shreyaans27/RISCV-tapeout/lef/report_final.txt

==============================================================================
LEF INSPECTION REPORT  --  original_backup/team2stdcells_final.lef
==============================================================================

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

------------------------------------------------------------------------------
DIRECTION FIELD USAGE (signal pins only)
------------------------------------------------------------------------------
  INOUT       126 pins
  (none)      2 pins

------------------------------------------------------------------------------
PER-CELL ANTENNA DATA PRESENCE
------------------------------------------------------------------------------

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

dfrtp_1        RESET    ---     INPUT_by_name           ANTENNADIFFAREAx3(0.5152@METAL1,0.5152@METAL2,0.5152@METAL3)  ANTENNAGATEAREAx3(0.2772@METAL1,0.2772@METAL2,0.5544@METAL3)  ANTENNAMAXAREACARx2(12.4163@METAL3,11.6858@METAL2)  ANTENNAMAXCUTCARx2(0.4877@VIA12,0.7316@VIA23)  ANTENNAMODELx1(OXIDE1)  ANTENNAPARTIALCUTAREAx2(0.1352@VIA12,0.0676@VIA23)  ANTENNAPARTIALMETALAREAx1(1.4424@METAL2)
dfrtp_1        NCLK     ---     INPUT_clock_by_name     ANTENNADIFFAREAx3(0.5152@METAL1,0.5152@METAL2,0.5152@METAL3)  ANTENNAGATEAREAx3(0.1980@METAL1,0.1980@METAL2,0.3960@METAL3)  ANTENNAMAXAREACARx2(3.9106@METAL3,1.8879@METAL2)  ANTENNAMAXCUTCARx2(0.6828@VIA12,1.0242@VIA23)  ANTENNAMODELx1(OXIDE1)  ANTENNAPARTIALCUTAREAx2(0.1352@VIA12,0.0676@VIA23)
dfrtp_1        D        INOUT   INPUT_by_name           ANTENNAGATEAREAx2(0.1980@METAL2,0.1980@METAL1)  ANTENNAMAXAREACARx1(1.8879@METAL2)  ANTENNAMAXCUTCARx1(0.6828@VIA12)  ANTENNAMODELx1(OXIDE1)  ANTENNAPARTIALCUTAREAx1(0.1352@VIA12)
dfrtp_1        Q        INOUT   OUTPUT_by_name          ANTENNADIFFAREAx2(0.7752@METAL2,0.2204@METAL1)  ANTENNAGATEAREAx2(0.1980@METAL2,0.1980@METAL1)  ANTENNAMAXAREACARx1(1.8879@METAL2)  ANTENNAMAXCUTCARx1(0.6828@VIA12)  ANTENNAMODELx1(OXIDE1)  ANTENNAPARTIALCUTAREAx1(0.1352@VIA12)
dfrtp_1        CLK      INOUT   INPUT_clock_by_name     ANTENNAGATEAREAx3(0.1584@METAL1,0.1584@METAL2,0.5544@METAL3)  ANTENNAMAXAREACARx2(5.5398@METAL3,2.7699@METAL2)  ANTENNAMAXCUTCARx2(0.8535@VIA12,1.2803@VIA23)  ANTENNAMODELx1(OXIDE1)  ANTENNAPARTIALCUTAREAx2(0.1352@VIA12,0.0676@VIA23)
dfrtp_1        RESET_B  INOUT   INPUT_by_name           ANTENNAGATEAREAx2(0.1584@METAL2,0.1584@METAL1)  ANTENNAMAXAREACARx1(2.7699@METAL2)  ANTENNAMAXCUTCARx1(0.8535@VIA12)  ANTENNAMODELx1(OXIDE1)  ANTENNAPARTIALCUTAREAx1(0.1352@VIA12)

dfsbp_1        CLK      INOUT   INPUT_clock_by_name     ANTENNAGATEAREAx2(0.1584@METAL2,0.1584@METAL1)  ANTENNAMAXAREACARx1(1.4205@METAL2)  ANTENNAMAXCUTCARx1(0.4268@VIA12)  ANTENNAMODELx1(OXIDE1)  ANTENNAPARTIALCUTAREAx1(0.0676@VIA12)
dfsbp_1        D        INOUT   INPUT_by_name           ANTENNAGATEAREAx2(0.1584@METAL2,0.1584@METAL1)  ANTENNAMAXAREACARx1(1.2784@METAL2)  ANTENNAMAXCUTCARx1(0.4268@VIA12)  ANTENNAMODELx1(OXIDE1)  ANTENNAPARTIALCUTAREAx1(0.0676@VIA12)
dfsbp_1        SET_B    INOUT   INPUT_by_name           ANTENNAGATEAREAx2(0.3168@METAL2,0.1584@METAL1)  ANTENNAMAXAREACARx1(1.6414@METAL2)  ANTENNAMAXCUTCARx1(0.4268@VIA12)  ANTENNAMODELx1(OXIDE1)  ANTENNAPARTIALCUTAREAx1(0.0676@VIA12)
dfsbp_1        Q_N      INOUT   OUTPUT_by_name          ANTENNADIFFAREAx2(0.5768@METAL2,0.5768@METAL1)  ANTENNAPARTIALCUTAREAx1(0.1352@VIA12)  ANTENNAPARTIALMETALAREAx1(0.2047@METAL2)
dfsbp_1        Q        INOUT   OUTPUT_by_name          ANTENNADIFFAREAx2(0.5768@METAL2,0.5768@METAL1)  ANTENNAPARTIALCUTAREAx1(0.1352@VIA12)  ANTENNAPARTIALMETALAREAx1(0.2092@METAL2)

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

dlxbp_1        Q_N      INOUT   OUTPUT_by_name          ANTENNADIFFAREAx2(0.5768@METAL2,0.5768@METAL1)  ANTENNAPARTIALCUTAREAx1(0.1352@VIA12)
dlxbp_1        D        INOUT   INPUT_by_name           ANTENNAGATEAREAx2(0.1584@METAL2,0.1584@METAL1)  ANTENNAMAXAREACARx1(1.2784@METAL2)  ANTENNAMAXCUTCARx1(0.4268@VIA12)  ANTENNAMODELx1(OXIDE1)  ANTENNAPARTIALCUTAREAx1(0.0676@VIA12)
dlxbp_1        Q        INOUT   OUTPUT_by_name          ANTENNADIFFAREAx2(0.5768@METAL2,0.5768@METAL1)  ANTENNAPARTIALCUTAREAx1(0.1352@VIA12)
dlxbp_1        GATE     INOUT   INPUT_clock_by_name     ANTENNAGATEAREAx2(0.1584@METAL2,0.1584@METAL1)  ANTENNAMAXAREACARx1(1.2784@METAL2)  ANTENNAMAXCUTCARx1(0.4268@VIA12)  ANTENNAMODELx1(OXIDE1)  ANTENNAPARTIALCUTAREAx1(0.0676@VIA12)

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

==============================================================================
SUMMARY
==============================================================================
Cells COMPLETE (38):
  a211o_2
  a21oi_1
  a21oi_2
  a21oi_4
  a21oi_8
  a22oi_1
  a22oi_2
  buf_1
  buf_16
  buf_2
  buf_4
  buf_8
  dfrtp_1
  dfsbp_1
  dfxtp_1
  dlxbp_1
  inv_1
  inv_16
  inv_2
  inv_4
  inv_8
  mux2
  mux2i
  nand2_1
  nand2_2
  nand2_4
  nand2_8
  nand2b_1
  nand4_1
  nor2_1
  nor2_4
  nor2_8
  o21ai_1
  o21ai_2
  o21ai_4
  o21ai_8
  xnor2_1
  xor2_1

Cells MISSING data (0):

------------------------------------------------------------------------------
PATTERN HINT: attributes present on COMPLETE cells
------------------------------------------------------------------------------
  On INPUT pins of complete cells:
    ANTENNAMODEL                    on 88 pins
    ANTENNAMAXCUTCAR                on 88 pins
    ANTENNAGATEAREA                 on 88 pins
    ANTENNAMAXAREACAR               on 88 pins
    ANTENNAPARTIALCUTAREA           on 88 pins
    ANTENNAPARTIALMETALAREA         on 18 pins
    ANTENNADIFFAREA                 on 2 pins

  On OUTPUT pins of complete cells:
    ANTENNADIFFAREA                 on 40 pins
    ANTENNAPARTIALCUTAREA           on 40 pins
    ANTENNAPARTIALMETALAREA         on 4 pins
    ANTENNAMODEL                    on 1 pins
    ANTENNAMAXCUTCAR                on 1 pins
    ANTENNAGATEAREA                 on 1 pins
    ANTENNAMAXAREACAR               on 1 pins

------------------------------------------------------------------------------
FAMILY COMPARISON
------------------------------------------------------------------------------

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

  Family 'dfrtp': ['dfrtp_1']
    dfrtp_1         RESET[IN]=['ANTENNADIFFAREA', 'ANTENNAGATEAREA', 'ANTENNAMAXAREACAR', 'ANTENNAMAXCUTCAR', 'ANTENNAMODEL', 'ANTENNAPARTIALCUTAREA', 'ANTENNAPARTIALMETALAREA']  |  NCLK[IN]=['ANTENNADIFFAREA', 'ANTENNAGATEAREA', 'ANTENNAMAXAREACAR', 'ANTENNAMAXCUTCAR', 'ANTENNAMODEL', 'ANTENNAPARTIALCUTAREA']  |  D[IN]=['ANTENNAGATEAREA', 'ANTENNAMAXAREACAR', 'ANTENNAMAXCUTCAR', 'ANTENNAMODEL', 'ANTENNAPARTIALCUTAREA']  |  Q[OUT]=['ANTENNADIFFAREA', 'ANTENNAGATEAREA', 'ANTENNAMAXAREACAR', 'ANTENNAMAXCUTCAR', 'ANTENNAMODEL', 'ANTENNAPARTIALCUTAREA']  |  CLK[IN]=['ANTENNAGATEAREA', 'ANTENNAMAXAREACAR', 'ANTENNAMAXCUTCAR', 'ANTENNAMODEL', 'ANTENNAPARTIALCUTAREA']  |  RESET_B[IN]=['ANTENNAGATEAREA', 'ANTENNAMAXAREACAR', 'ANTENNAMAXCUTCAR', 'ANTENNAMODEL', 'ANTENNAPARTIALCUTAREA']

  Family 'dfsbp': ['dfsbp_1']
    dfsbp_1         CLK[IN]=['ANTENNAGATEAREA', 'ANTENNAMAXAREACAR', 'ANTENNAMAXCUTCAR', 'ANTENNAMODEL', 'ANTENNAPARTIALCUTAREA']  |  D[IN]=['ANTENNAGATEAREA', 'ANTENNAMAXAREACAR', 'ANTENNAMAXCUTCAR', 'ANTENNAMODEL', 'ANTENNAPARTIALCUTAREA']  |  SET_B[IN]=['ANTENNAGATEAREA', 'ANTENNAMAXAREACAR', 'ANTENNAMAXCUTCAR', 'ANTENNAMODEL', 'ANTENNAPARTIALCUTAREA']  |  Q_N[OUT]=['ANTENNADIFFAREA', 'ANTENNAPARTIALCUTAREA', 'ANTENNAPARTIALMETALAREA']  |  Q[OUT]=['ANTENNADIFFAREA', 'ANTENNAPARTIALCUTAREA', 'ANTENNAPARTIALMETALAREA']

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

  Family 'dlxbp': ['dlxbp_1']
    dlxbp_1         Q_N[OUT]=['ANTENNADIFFAREA', 'ANTENNAPARTIALCUTAREA']  |  D[IN]=['ANTENNAGATEAREA', 'ANTENNAMAXAREACAR', 'ANTENNAMAXCUTCAR', 'ANTENNAMODEL', 'ANTENNAPARTIALCUTAREA']  |  Q[OUT]=['ANTENNADIFFAREA', 'ANTENNAPARTIALCUTAREA']  |  GATE[IN]=['ANTENNAGATEAREA', 'ANTENNAMAXAREACAR', 'ANTENNAMAXCUTCAR', 'ANTENNAMODEL', 'ANTENNAPARTIALCUTAREA']

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

==============================================================================
END OF REPORT
==============================================================================
