shreyaans27/RISCV-tapeout/lef/report_wSideArea.txt

==============================================================================
LEF INSPECTION REPORT  --  original_backup/team2stdcells_final_wSideArea.lef
==============================================================================

Total MACROs parsed: 38
MACRO names: ['a211o_2', 'a21oi_1', 'a21oi_2', 'a21oi_4', 'a21oi_8', 'a22oi_1', 'a22oi_2', 'buf_1', 'buf_16', 'buf_2', 'buf_4', 'buf_8', 'dfrtp_1', 'dfsbp_1', 'dfxtp_1', 'dlxbp_1', 'inv_1', 'inv_16', 'inv_2', 'inv_4', 'inv_8', 'mux2', 'mux2i', 'nand2_1', 'nand2_2', 'nand2_4', 'nand2_8', 'nand2b_1', 'nand4_1', 'nor2_1', 'nor2_4', 'nor2_8', 'o21ai_1', 'o21ai_2', 'o21ai_4', 'o21ai_8', 'xnor2_1', 'xor2_1']

------------------------------------------------------------------------------
DIRECTION FIELD USAGE (signal pins only)
------------------------------------------------------------------------------
  INOUT       126 pins
  (none)      2 pins

------------------------------------------------------------------------------
PER-CELL ANTENNA DATA PRESENCE
------------------------------------------------------------------------------

CELL           PIN      DIR     NAME_IMPLIES            ANTENNA_ATTRS
------------------------------------------------------------------------------
a211o_2        X        INOUT   OUTPUT_by_name          ANTENNADIFFAREAx2(0.5676@METAL2,0.5676@METAL1)  ANTENNAPARTIALCUTAREAx1(0.1352@VIA12)  ANTENNAPARTIALMETALSIDEAREAx2(4.2294@METAL1,1.4310@METAL2)
a211o_2        A2       INOUT   INPUT_by_name           ANTENNAGATEAREAx2(0.1584@METAL2,0.1584@METAL1)  ANTENNAMAXAREACARx1(1.2784@METAL2)  ANTENNAMAXCUTCARx1(0.4268@VIA12)  ANTENNAMODELx1(OXIDE1)  ANTENNAPARTIALCUTAREAx1(0.0676@VIA12)  ANTENNAPARTIALMETALSIDEAREAx2(0.9540@METAL1,0.9540@METAL2)
a211o_2        C1       INOUT   INPUT_by_name           ANTENNAGATEAREAx2(0.1584@METAL2,0.1584@METAL1)  ANTENNAMAXAREACARx1(1.2784@METAL2)  ANTENNAMAXCUTCARx1(0.4268@VIA12)  ANTENNAMODELx1(OXIDE1)  ANTENNAPARTIALCUTAREAx1(0.0676@VIA12)  ANTENNAPARTIALMETALSIDEAREAx2(0.9540@METAL1,0.9540@METAL2)
a211o_2        B1       INOUT   INPUT_by_name           ANTENNAGATEAREAx2(0.1584@METAL2,0.1584@METAL1)  ANTENNAMAXAREACARx1(1.2784@METAL2)  ANTENNAMAXCUTCARx1(0.4268@VIA12)  ANTENNAMODELx1(OXIDE1)  ANTENNAPARTIALCUTAREAx1(0.0676@VIA12)  ANTENNAPARTIALMETALSIDEAREAx2(0.9540@METAL1,0.9699@METAL2)
a211o_2        A1       INOUT   INPUT_by_name           ANTENNAGATEAREAx2(0.1584@METAL2,0.1584@METAL1)  ANTENNAMAXAREACARx1(1.2784@METAL2)  ANTENNAMAXCUTCARx1(0.4268@VIA12)  ANTENNAMODELx1(OXIDE1)  ANTENNAPARTIALCUTAREAx1(0.0676@VIA12)  ANTENNAPARTIALMETALSIDEAREAx2(0.9540@METAL1,0.9540@METAL2)

a21oi_1        Y        INOUT   OUTPUT_by_name          ANTENNADIFFAREAx2(0.7752@METAL2,0.2204@METAL1)  ANTENNAPARTIALCUTAREAx1(0.0676@VIA12)  ANTENNAPARTIALMETALSIDEAREAx2(9.2856@METAL1,3.0263@METAL2)
a21oi_1        A1       INOUT   INPUT_by_name           ANTENNAGATEAREAx2(0.3168@METAL2,0.3168@METAL1)  ANTENNAMAXAREACARx1(0.6392@METAL2)  ANTENNAMAXCUTCARx1(0.2134@VIA12)  ANTENNAMODELx1(OXIDE1)  ANTENNAPARTIALCUTAREAx1(0.0676@VIA12)  ANTENNAPARTIALMETALSIDEAREAx2(0.9540@METAL1,0.9540@METAL2)
a21oi_1        B1       INOUT   INPUT_by_name           ANTENNAGATEAREAx2(0.2772@METAL2,0.2772@METAL1)  ANTENNAMAXAREACARx1(1.8525@METAL2)  ANTENNAMAXCUTCARx1(0.2439@VIA12)  ANTENNAMODELx1(OXIDE1)  ANTENNAPARTIALCUTAREAx1(0.0676@VIA12)  ANTENNAPARTIALMETALSIDEAREAx2(2.6500@METAL1,0.9540@METAL2)
a21oi_1        A2       INOUT   INPUT_by_name           ANTENNAGATEAREAx2(0.3168@METAL2,0.3168@METAL1)  ANTENNAMAXAREACARx1(0.6392@METAL2)  ANTENNAMAXCUTCARx1(0.2134@VIA12)  ANTENNAMODELx1(OXIDE1)  ANTENNAPARTIALCUTAREAx1(0.0676@VIA12)  ANTENNAPARTIALMETALSIDEAREAx2(0.9540@METAL1,0.9540@METAL2)

a21oi_2        Y        INOUT   OUTPUT_by_name          ANTENNADIFFAREAx2(1.3740@METAL2,0.2204@METAL1)  ANTENNAPARTIALCUTAREAx1(0.0676@VIA12)  ANTENNAPARTIALMETALSIDEAREAx2(11.4215@METAL1,6.3971@METAL2)
a21oi_2        A1       INOUT   INPUT_by_name           ANTENNAGATEAREAx2(0.6336@METAL2,0.6336@METAL1)  ANTENNAMAXAREACARx1(1.8568@METAL2)  ANTENNAMAXCUTCARx1(0.1067@VIA12)  ANTENNAMODELx1(OXIDE1)  ANTENNAPARTIALCUTAREAx1(0.0676@VIA12)  ANTENNAPARTIALMETALSIDEAREAx2(3.1747@METAL1,0.9699@METAL2)
a21oi_2        B1       INOUT   INPUT_by_name           ANTENNAGATEAREAx2(0.5544@METAL2,0.5544@METAL1)  ANTENNAMAXAREACARx1(0.8201@METAL2)  ANTENNAMAXCUTCARx1(0.1219@VIA12)  ANTENNAMODELx1(OXIDE1)  ANTENNAPARTIALCUTAREAx1(0.0676@VIA12)  ANTENNAPARTIALMETALSIDEAREAx2(3.2966@METAL1,0.9593@METAL2)
a21oi_2        A2       INOUT   INPUT_by_name           ANTENNAGATEAREAx2(0.6336@METAL2,0.6336@METAL1)  ANTENNAMAXAREACARx1(1.8568@METAL2)  ANTENNAMAXCUTCARx1(0.1067@VIA12)  ANTENNAMODELx1(OXIDE1)  ANTENNAPARTIALCUTAREAx1(0.0676@VIA12)  ANTENNAPARTIALMETALSIDEAREAx2(3.1747@METAL1,0.9699@METAL2)

a21oi_4        Y        INOUT   OUTPUT_by_name          ANTENNADIFFAREAx2(2.7480@METAL2,0.2204@METAL1)  ANTENNAPARTIALCUTAREAx1(0.0676@VIA12)  ANTENNAPARTIALMETALSIDEAREAx2(21.6664@METAL1,7.3882@METAL2)
a21oi_4        A2       INOUT   INPUT_by_name           ANTENNAGATEAREAx2(1.2672@METAL2,1.2672@METAL1)  ANTENNAMAXAREACARx1(1.5013@METAL2)  ANTENNAMAXCUTCARx1(0.0533@VIA12)  ANTENNAMODELx1(OXIDE1)  ANTENNAPARTIALCUTAREAx1(0.0676@VIA12)  ANTENNAPARTIALMETALSIDEAREAx2(7.0914@METAL1,0.9540@METAL2)
a21oi_4        A1       INOUT   INPUT_by_name           ANTENNAGATEAREAx2(1.2672@METAL2,1.2672@METAL1)  ANTENNAMAXAREACARx1(1.4598@METAL2)  ANTENNAMAXCUTCARx1(0.0533@VIA12)  ANTENNAMODELx1(OXIDE1)  ANTENNAPARTIALCUTAREAx1(0.0676@VIA12)  ANTENNAPARTIALMETALSIDEAREAx2(6.9271@METAL1,0.9540@METAL2)
a21oi_4        B1       INOUT   INPUT_by_name           ANTENNAGATEAREAx2(1.1088@METAL2,1.1088@METAL1)  ANTENNAMAXAREACARx1(1.2681@METAL2)  ANTENNAMAXCUTCARx1(0.0610@VIA12)  ANTENNAMODELx1(OXIDE1)  ANTENNAPARTIALCUTAREAx1(0.0676@VIA12)  ANTENNAPARTIALMETALSIDEAREAx2(5.5438@METAL1,0.9540@METAL2)

a21oi_8        Y        INOUT   OUTPUT_by_name          ANTENNADIFFAREAx2(5.4960@METAL2,0.2204@METAL1)  ANTENNAPARTIALCUTAREAx1(0.1352@VIA12)  ANTENNAPARTIALMETALSIDEAREAx2(42.2993@METAL1,15.7251@METAL2)
a21oi_8        A2       INOUT   INPUT_by_name           ANTENNAGATEAREAx2(2.5344@METAL2,2.5344@METAL1)  ANTENNAMAXAREACARx1(1.5567@METAL2)  ANTENNAMAXCUTCARx1(0.0533@VIA12)  ANTENNAMODELx1(OXIDE1)  ANTENNAPARTIALCUTAREAx1(0.1352@VIA12)  ANTENNAPARTIALMETALSIDEAREAx2(13.8330@METAL1,1.5052@METAL2)
a21oi_8        A1       INOUT   INPUT_by_name           ANTENNAGATEAREAx2(2.5344@METAL2,2.5344@METAL1)  ANTENNAMAXAREACARx1(1.5500@METAL2)  ANTENNAMAXCUTCARx1(0.0533@VIA12)  ANTENNAMODELx1(OXIDE1)  ANTENNAPARTIALCUTAREAx1(0.1352@VIA12)  ANTENNAPARTIALMETALSIDEAREAx2(13.7800@METAL1,1.5052@METAL2)
a21oi_8        B1       INOUT   INPUT_by_name           ANTENNAGATEAREAx2(2.2176@METAL2,2.2176@METAL1)  ANTENNAMAXAREACARx1(1.2305@METAL2)  ANTENNAMAXCUTCARx1(0.0610@VIA12)  ANTENNAMODELx1(OXIDE1)  ANTENNAPARTIALCUTAREAx1(0.1352@VIA12)  ANTENNAPARTIALMETALSIDEAREAx2(10.1124@METAL1,1.3568@METAL2)

a22oi_1        B2       INOUT   INPUT_by_name           ANTENNAGATEAREAx2(0.3168@METAL2,0.3168@METAL1)  ANTENNAMAXAREACARx1(1.3636@METAL2)  ANTENNAMAXCUTCARx1(0.2134@VIA12)  ANTENNAMODELx1(OXIDE1)  ANTENNAPARTIALCUTAREAx1(0.0676@VIA12)  ANTENNAPARTIALMETALSIDEAREAx2(2.5069@METAL1,0.9540@METAL2)
a22oi_1        Y        INOUT   OUTPUT_by_name          ANTENNADIFFAREAx2(1.4476@METAL2,1.4476@METAL1)  ANTENNAPARTIALCUTAREAx1(0.1352@VIA12)  ANTENNAPARTIALMETALSIDEAREAx2(11.2943@METAL1,1.4310@METAL2)
a22oi_1        B1       INOUT   INPUT_by_name           ANTENNAGATEAREAx2(0.3168@METAL2,0.3168@METAL1)  ANTENNAMAXAREACARx1(0.6597@METAL2)  ANTENNAMAXCUTCARx1(0.2134@VIA12)  ANTENNAMODELx1(OXIDE1)  ANTENNAPARTIALCUTAREAx1(0.0676@VIA12)  ANTENNAPARTIALMETALSIDEAREAx2(1.7702@METAL1,0.9540@METAL2)
a22oi_1        A2       INOUT   INPUT_by_name           ANTENNAGATEAREAx2(0.3168@METAL2,0.3168@METAL1)  ANTENNAMAXAREACARx1(1.3636@METAL2)  ANTENNAMAXCUTCARx1(0.2134@VIA12)  ANTENNAMODELx1(OXIDE1)  ANTENNAPARTIALCUTAREAx1(0.0676@VIA12)  ANTENNAPARTIALMETALSIDEAREAx2(2.5069@METAL1,0.9540@METAL2)
a22oi_1        A1       INOUT   INPUT_by_name           ANTENNAGATEAREAx2(0.3168@METAL2,0.3168@METAL1)  ANTENNAMAXAREACARx1(0.6392@METAL2)  ANTENNAMAXCUTCARx1(0.2134@VIA12)  ANTENNAMODELx1(OXIDE1)  ANTENNAPARTIALCUTAREAx1(0.0676@VIA12)  ANTENNAPARTIALMETALSIDEAREAx2(0.9540@METAL1,0.9540@METAL2)

a22oi_2        A2       INOUT   INPUT_by_name           ANTENNAGATEAREAx2(0.6336@METAL2,0.6336@METAL1)  ANTENNAMAXAREACARx1(1.4653@METAL2)  ANTENNAMAXCUTCARx1(0.1067@VIA12)  ANTENNAMODELx1(OXIDE1)  ANTENNAPARTIALCUTAREAx1(0.0676@VIA12)  ANTENNAPARTIALMETALSIDEAREAx2(4.0545@METAL1,0.9540@METAL2)
a22oi_2        A1       INOUT   INPUT_by_name           ANTENNAGATEAREAx2(0.6336@METAL2,0.6336@METAL1)  ANTENNAMAXAREACARx1(1.4653@METAL2)  ANTENNAMAXCUTCARx1(0.1067@VIA12)  ANTENNAMODELx1(OXIDE1)  ANTENNAPARTIALCUTAREAx1(0.0676@VIA12)  ANTENNAPARTIALMETALSIDEAREAx2(4.0545@METAL1,0.9540@METAL2)
a22oi_2        Y        INOUT   OUTPUT_by_name          ANTENNADIFFAREAx2(2.8112@METAL2,2.8112@METAL1)  ANTENNAPARTIALCUTAREAx1(0.1352@VIA12)  ANTENNAPARTIALMETALSIDEAREAx2(20.3626@METAL1,1.4310@METAL2)
a22oi_2        B1       INOUT   INPUT_by_name           ANTENNAGATEAREAx2(0.6336@METAL2,0.6336@METAL1)  ANTENNAMAXAREACARx1(1.0184@METAL2)  ANTENNAMAXCUTCARx1(0.1067@VIA12)  ANTENNAMODELx1(OXIDE1)  ANTENNAPARTIALCUTAREAx1(0.0676@VIA12)  ANTENNAPARTIALMETALSIDEAREAx2(3.1429@METAL1,0.9540@METAL2)
a22oi_2        B2       INOUT   INPUT_by_name           ANTENNAGATEAREAx2(0.6336@METAL2,0.6336@METAL1)  ANTENNAMAXAREACARx1(1.4653@METAL2)  ANTENNAMAXCUTCARx1(0.1067@VIA12)  ANTENNAMODELx1(OXIDE1)  ANTENNAPARTIALCUTAREAx1(0.0676@VIA12)  ANTENNAPARTIALMETALSIDEAREAx2(4.0545@METAL1,0.9540@METAL2)

buf_1          A        INOUT   INPUT_by_name           ANTENNAGATEAREAx2(0.1584@METAL2,0.1584@METAL1)  ANTENNAMAXAREACARx1(1.2784@METAL2)  ANTENNAMAXCUTCARx1(0.4268@VIA12)  ANTENNAMODELx1(OXIDE1)  ANTENNAPARTIALCUTAREAx1(0.0676@VIA12)  ANTENNAPARTIALMETALSIDEAREAx2(0.9540@METAL1,0.9540@METAL2)
buf_1          X        INOUT   OUTPUT_by_name          ANTENNADIFFAREAx2(0.5152@METAL2,0.5152@METAL1)  ANTENNAPARTIALCUTAREAx1(0.2028@VIA12)  ANTENNAPARTIALMETALSIDEAREAx2(5.0403@METAL1,1.9822@METAL2)

buf_16         X        INOUT   OUTPUT_by_name          ANTENNADIFFAREAx2(4.6144@METAL2,4.6144@METAL1)  ANTENNAPARTIALCUTAREAx1(0.2028@VIA12)  ANTENNAPARTIALMETALSIDEAREAx2(46.9898@METAL1,1.9822@METAL2)
buf_16         A        INOUT   INPUT_by_name           ANTENNAGATEAREAx2(0.9504@METAL2,0.9504@METAL1)  ANTENNAMAXAREACARx1(2.3674@METAL2)  ANTENNAMAXCUTCARx1(0.2134@VIA12)  ANTENNAMODELx1(OXIDE1)  ANTENNAPARTIALCUTAREAx1(0.2028@VIA12)  ANTENNAPARTIALMETALAREAx1(0.4050@METAL2)  ANTENNAPARTIALMETALSIDEAREAx2(4.8230@METAL1,2.8620@METAL2)

buf_2          A        INOUT   INPUT_by_name           ANTENNAGATEAREAx2(0.1584@METAL2,0.1584@METAL1)  ANTENNAMAXAREACARx1(1.2784@METAL2)  ANTENNAMAXCUTCARx1(0.4268@VIA12)  ANTENNAMODELx1(OXIDE1)  ANTENNAPARTIALCUTAREAx1(0.0676@VIA12)  ANTENNAPARTIALMETALSIDEAREAx2(0.9540@METAL1,0.9540@METAL2)
buf_2          X        INOUT   OUTPUT_by_name          ANTENNADIFFAREAx2(0.5768@METAL2,0.5768@METAL1)  ANTENNAPARTIALCUTAREAx1(0.2028@VIA12)  ANTENNAPARTIALMETALSIDEAREAx2(7.5260@METAL1,1.9822@METAL2)

buf_4          A        INOUT   INPUT_by_name           ANTENNAGATEAREAx2(0.1584@METAL2,0.1584@METAL1)  ANTENNAMAXAREACARx1(1.2784@METAL2)  ANTENNAMAXCUTCARx1(0.4268@VIA12)  ANTENNAMODELx1(OXIDE1)  ANTENNAPARTIALCUTAREAx1(0.0676@VIA12)  ANTENNAPARTIALMETALSIDEAREAx2(0.9540@METAL1,0.9540@METAL2)
buf_4          X        INOUT   OUTPUT_by_name          ANTENNADIFFAREAx2(1.1536@METAL2,1.1536@METAL1)  ANTENNAPARTIALCUTAREAx1(0.2028@VIA12)  ANTENNAPARTIALMETALSIDEAREAx2(11.4056@METAL1,1.9822@METAL2)

buf_8          A        INOUT   INPUT_by_name           ANTENNAGATEAREAx2(0.4752@METAL2,0.4752@METAL1)  ANTENNAMAXAREACARx1(2.6610@METAL2)  ANTENNAMAXCUTCARx1(0.4268@VIA12)  ANTENNAMODELx1(OXIDE1)  ANTENNAPARTIALCUTAREAx1(0.2028@VIA12)  ANTENNAPARTIALMETALAREAx1(0.4050@METAL2)  ANTENNAPARTIALMETALSIDEAREAx2(2.5016@METAL1,2.8620@METAL2)
buf_8          X        INOUT   OUTPUT_by_name          ANTENNADIFFAREAx2(2.3072@METAL2,2.3072@METAL1)  ANTENNAPARTIALCUTAREAx1(0.2028@VIA12)  ANTENNAPARTIALMETALSIDEAREAx2(24.4224@METAL1,1.9822@METAL2)

dfrtp_1        RESET    ---     INPUT_by_name           ANTENNADIFFAREAx3(0.5152@METAL1,0.5152@METAL2,0.5152@METAL3)  ANTENNAGATEAREAx3(0.2772@METAL1,0.2772@METAL2,0.5544@METAL3)  ANTENNAMAXAREACARx2(12.4163@METAL3,11.6858@METAL2)  ANTENNAMAXCUTCARx2(0.4877@VIA12,0.7316@VIA23)  ANTENNAMODELx1(OXIDE1)  ANTENNAPARTIALCUTAREAx2(0.1352@VIA12,0.0676@VIA23)  ANTENNAPARTIALMETALAREAx1(1.4424@METAL2)  ANTENNAPARTIALMETALSIDEAREAx3(9.6036@METAL1,8.9941@METAL2,19.1966@METAL3)
dfrtp_1        NCLK     ---     INPUT_clock_by_name     ANTENNADIFFAREAx3(0.5152@METAL1,0.5152@METAL2,0.5152@METAL3)  ANTENNAGATEAREAx3(0.1980@METAL1,0.1980@METAL2,0.3960@METAL3)  ANTENNAMAXAREACARx2(3.9106@METAL3,1.8879@METAL2)  ANTENNAMAXCUTCARx2(0.6828@VIA12,1.0242@VIA23)  ANTENNAMODELx1(OXIDE1)  ANTENNAPARTIALCUTAREAx2(0.1352@VIA12,0.0676@VIA23)  ANTENNAPARTIALMETALSIDEAREAx3(5.9890@METAL1,3.7948@METAL2,19.3821@METAL3)
dfrtp_1        D        INOUT   INPUT_by_name           ANTENNAGATEAREAx2(0.1980@METAL2,0.1980@METAL1)  ANTENNAMAXAREACARx1(1.8879@METAL2)  ANTENNAMAXCUTCARx1(0.6828@VIA12)  ANTENNAMODELx1(OXIDE1)  ANTENNAPARTIALCUTAREAx1(0.1352@VIA12)  ANTENNAPARTIALMETALSIDEAREAx2(1.3886@METAL1,1.4204@METAL2)
dfrtp_1        Q        INOUT   OUTPUT_by_name          ANTENNADIFFAREAx2(0.7752@METAL2,0.2204@METAL1)  ANTENNAGATEAREAx2(0.1980@METAL2,0.1980@METAL1)  ANTENNAMAXAREACARx1(1.8879@METAL2)  ANTENNAMAXCUTCARx1(0.6828@VIA12)  ANTENNAMODELx1(OXIDE1)  ANTENNAPARTIALCUTAREAx1(0.1352@VIA12)  ANTENNAPARTIALMETALSIDEAREAx2(10.6742@METAL1,14.3630@METAL2)
dfrtp_1        CLK      INOUT   INPUT_clock_by_name     ANTENNAGATEAREAx3(0.1584@METAL1,0.1584@METAL2,0.5544@METAL3)  ANTENNAMAXAREACARx2(5.5398@METAL3,2.7699@METAL2)  ANTENNAMAXCUTCARx2(0.8535@VIA12,1.2803@VIA23)  ANTENNAMODELx1(OXIDE1)  ANTENNAPARTIALCUTAREAx2(0.1352@VIA12,0.0676@VIA23)  ANTENNAPARTIALMETALSIDEAREAx3(4.2877@METAL1,4.3513@METAL2,9.6407@METAL3)
dfrtp_1        RESET_B  INOUT   INPUT_by_name           ANTENNAGATEAREAx2(0.1584@METAL2,0.1584@METAL1)  ANTENNAMAXAREACARx1(2.7699@METAL2)  ANTENNAMAXCUTCARx1(0.8535@VIA12)  ANTENNAMODELx1(OXIDE1)  ANTENNAPARTIALCUTAREAx1(0.1352@VIA12)  ANTENNAPARTIALMETALSIDEAREAx2(1.5105@METAL1,1.5105@METAL2)

dfsbp_1        CLK      INOUT   INPUT_clock_by_name     ANTENNAGATEAREAx2(0.1584@METAL2,0.1584@METAL1)  ANTENNAMAXAREACARx1(1.4205@METAL2)  ANTENNAMAXCUTCARx1(0.4268@VIA12)  ANTENNAMODELx1(OXIDE1)  ANTENNAPARTIALCUTAREAx1(0.0676@VIA12)  ANTENNAPARTIALMETALSIDEAREAx2(1.0070@METAL1,1.0070@METAL2)
dfsbp_1        D        INOUT   INPUT_by_name           ANTENNAGATEAREAx2(0.1584@METAL2,0.1584@METAL1)  ANTENNAMAXAREACARx1(1.2784@METAL2)  ANTENNAMAXCUTCARx1(0.4268@VIA12)  ANTENNAMODELx1(OXIDE1)  ANTENNAPARTIALCUTAREAx1(0.0676@VIA12)  ANTENNAPARTIALMETALSIDEAREAx2(0.9540@METAL1,0.9540@METAL2)
dfsbp_1        SET_B    INOUT   INPUT_by_name           ANTENNAGATEAREAx2(0.3168@METAL2,0.1584@METAL1)  ANTENNAMAXAREACARx1(1.6414@METAL2)  ANTENNAMAXCUTCARx1(0.4268@VIA12)  ANTENNAMODELx1(OXIDE1)  ANTENNAPARTIALCUTAREAx1(0.0676@VIA12)  ANTENNAPARTIALMETALSIDEAREAx2(2.8832@METAL1,9.3598@METAL2)
dfsbp_1        Q_N      INOUT   OUTPUT_by_name          ANTENNADIFFAREAx2(0.5768@METAL2,0.5768@METAL1)  ANTENNAPARTIALCUTAREAx1(0.1352@VIA12)  ANTENNAPARTIALMETALAREAx1(0.2047@METAL2)  ANTENNAPARTIALMETALSIDEAREAx2(5.6604@METAL1,1.9186@METAL2)
dfsbp_1        Q        INOUT   OUTPUT_by_name          ANTENNADIFFAREAx2(0.5768@METAL2,0.5768@METAL1)  ANTENNAPARTIALCUTAREAx1(0.1352@VIA12)  ANTENNAPARTIALMETALAREAx1(0.2092@METAL2)  ANTENNAPARTIALMETALSIDEAREAx2(6.0579@METAL1,1.9398@METAL2)

dfxtp_1        Q        INOUT   OUTPUT_by_name          ANTENNADIFFAREAx2(0.5152@METAL2,0.5152@METAL1)  ANTENNAPARTIALCUTAREAx1(0.1352@VIA12)  ANTENNAPARTIALMETALSIDEAREAx2(5.3636@METAL1,1.4310@METAL2)
dfxtp_1        CLK      INOUT   INPUT_clock_by_name     ANTENNAGATEAREAx2(0.1584@METAL2,0.1584@METAL1)  ANTENNAMAXAREACARx1(1.2784@METAL2)  ANTENNAMAXCUTCARx1(0.4268@VIA12)  ANTENNAMODELx1(OXIDE1)  ANTENNAPARTIALCUTAREAx1(0.0676@VIA12)  ANTENNAPARTIALMETALSIDEAREAx2(0.9540@METAL1,0.9540@METAL2)
dfxtp_1        D        INOUT   INPUT_by_name           ANTENNAGATEAREAx2(0.1584@METAL2,0.1584@METAL1)  ANTENNAMAXAREACARx1(2.6989@METAL2)  ANTENNAMAXCUTCARx1(0.4268@VIA12)  ANTENNAMODELx1(OXIDE1)  ANTENNAPARTIALCUTAREAx1(0.0676@VIA12)  ANTENNAPARTIALMETALSIDEAREAx2(1.4840@METAL1,2.4963@METAL2)

dlxbp_1        Q_N      INOUT   OUTPUT_by_name          ANTENNADIFFAREAx2(0.5768@METAL2,0.5768@METAL1)  ANTENNAPARTIALCUTAREAx1(0.1352@VIA12)  ANTENNAPARTIALMETALSIDEAREAx2(6.4289@METAL1,1.4310@METAL2)
dlxbp_1        D        INOUT   INPUT_by_name           ANTENNAGATEAREAx2(0.1584@METAL2,0.1584@METAL1)  ANTENNAMAXAREACARx1(1.2784@METAL2)  ANTENNAMAXCUTCARx1(0.4268@VIA12)  ANTENNAMODELx1(OXIDE1)  ANTENNAPARTIALCUTAREAx1(0.0676@VIA12)  ANTENNAPARTIALMETALSIDEAREAx2(0.9540@METAL1,0.9540@METAL2)
dlxbp_1        Q        INOUT   OUTPUT_by_name          ANTENNADIFFAREAx2(0.5768@METAL2,0.5768@METAL1)  ANTENNAPARTIALCUTAREAx1(0.1352@VIA12)  ANTENNAPARTIALMETALSIDEAREAx2(5.3954@METAL1,1.4310@METAL2)
dlxbp_1        GATE     INOUT   INPUT_clock_by_name     ANTENNAGATEAREAx2(0.1584@METAL2,0.1584@METAL1)  ANTENNAMAXAREACARx1(1.2784@METAL2)  ANTENNAMAXCUTCARx1(0.4268@VIA12)  ANTENNAMODELx1(OXIDE1)  ANTENNAPARTIALCUTAREAx1(0.0676@VIA12)  ANTENNAPARTIALMETALSIDEAREAx2(0.9540@METAL1,0.9699@METAL2)

inv_1          Y        INOUT   OUTPUT_by_name          ANTENNADIFFAREAx2(0.5152@METAL2,0.1984@METAL1)  ANTENNAPARTIALCUTAREAx1(0.0676@VIA12)  ANTENNAPARTIALMETALSIDEAREAx2(2.5546@METAL1,3.2118@METAL2)
inv_1          A        INOUT   INPUT_by_name           ANTENNAGATEAREAx2(0.1584@METAL2,0.1584@METAL1)  ANTENNAMAXAREACARx1(2.7699@METAL2)  ANTENNAMAXCUTCARx1(0.8535@VIA12)  ANTENNAMODELx1(OXIDE1)  ANTENNAPARTIALCUTAREAx1(0.1352@VIA12)  ANTENNAPARTIALMETALSIDEAREAx2(1.5105@METAL1,1.5105@METAL2)

inv_16         A        INOUT   INPUT_by_name           ANTENNAGATEAREAx2(2.5344@METAL2,2.5344@METAL1)  ANTENNAMAXAREACARx1(2.0517@METAL2)  ANTENNAMAXCUTCARx1(0.0800@VIA12)  ANTENNAMODELx1(OXIDE1)  ANTENNAPARTIALCUTAREAx1(0.2028@VIA12)  ANTENNAPARTIALMETALAREAx1(0.4050@METAL2)  ANTENNAPARTIALMETALSIDEAREAx2(11.7713@METAL1,2.8620@METAL2)
inv_16         Y        INOUT   OUTPUT_by_name          ANTENNADIFFAREAx2(4.6144@METAL2,4.6144@METAL1)  ANTENNAPARTIALCUTAREAx1(0.2028@VIA12)  ANTENNAPARTIALMETALSIDEAREAx2(41.2128@METAL1,2.0034@METAL2)

inv_2          Y        INOUT   OUTPUT_by_name          ANTENNADIFFAREAx2(0.5768@METAL2,0.5768@METAL1)  ANTENNAPARTIALCUTAREAx1(0.2704@VIA12)  ANTENNAPARTIALMETALAREAx1(0.4050@METAL2)  ANTENNAPARTIALMETALSIDEAREAx2(7.8758@METAL1,2.8620@METAL2)
inv_2          A        INOUT   INPUT_by_name           ANTENNAGATEAREAx2(0.3168@METAL2,0.3168@METAL1)  ANTENNAMAXAREACARx1(2.3153@METAL2)  ANTENNAMAXCUTCARx1(0.4268@VIA12)  ANTENNAMODELx1(OXIDE1)  ANTENNAPARTIALCUTAREAx1(0.1352@VIA12)  ANTENNAPARTIALMETALAREAx1(0.2025@METAL2)  ANTENNAPARTIALMETALSIDEAREAx2(1.7278@METAL1,1.9080@METAL2)

inv_4          Y        INOUT   OUTPUT_by_name          ANTENNADIFFAREAx2(1.1536@METAL2,1.1536@METAL1)  ANTENNAPARTIALCUTAREAx1(0.1352@VIA12)  ANTENNAPARTIALMETALSIDEAREAx2(12.8684@METAL1,1.4363@METAL2)
inv_4          A        INOUT   INPUT_by_name           ANTENNAGATEAREAx2(0.6336@METAL2,0.6336@METAL1)  ANTENNAMAXAREACARx1(0.5398@METAL2)  ANTENNAMAXCUTCARx1(0.2134@VIA12)  ANTENNAMODELx1(OXIDE1)  ANTENNAPARTIALCUTAREAx1(0.1352@VIA12)  ANTENNAPARTIALMETALSIDEAREAx2(1.3568@METAL1,2.7825@METAL2)

inv_8          Y        INOUT   OUTPUT_by_name          ANTENNADIFFAREAx2(2.3072@METAL2,2.3072@METAL1)  ANTENNAPARTIALCUTAREAx1(0.4056@VIA12)  ANTENNAPARTIALMETALAREAx1(0.6480@METAL2)  ANTENNAPARTIALMETALSIDEAREAx2(27.0936@METAL1,4.0068@METAL2)
inv_8          A        INOUT   INPUT_by_name           ANTENNAGATEAREAx2(1.2672@METAL2,1.2672@METAL1)  ANTENNAMAXAREACARx1(2.1342@METAL2)  ANTENNAMAXCUTCARx1(0.1067@VIA12)  ANTENNAMODELx1(OXIDE1)  ANTENNAPARTIALCUTAREAx1(0.1352@VIA12)  ANTENNAPARTIALMETALAREAx1(0.2025@METAL2)  ANTENNAPARTIALMETALSIDEAREAx2(6.3706@METAL1,1.9080@METAL2)

mux2           X        INOUT   OUTPUT_by_name          ANTENNADIFFAREAx2(0.6175@METAL2,0.6175@METAL1)  ANTENNAPARTIALCUTAREAx1(0.2028@VIA12)  ANTENNAPARTIALMETALSIDEAREAx2(6.0632@METAL1,1.9822@METAL2)
mux2           A1       INOUT   INPUT_by_name           ANTENNAGATEAREAx2(0.1584@METAL2,0.1584@METAL1)  ANTENNAMAXAREACARx1(3.8842@METAL2)  ANTENNAMAXCUTCARx1(0.4268@VIA12)  ANTENNAMODELx1(OXIDE1)  ANTENNAPARTIALCUTAREAx1(0.0676@VIA12)  ANTENNAPARTIALMETALSIDEAREAx2(5.2364@METAL1,0.9593@METAL2)
mux2           S        INOUT   INPUT_by_name           ANTENNAGATEAREAx2(0.3168@METAL2,0.3168@METAL1)  ANTENNAMAXAREACARx1(5.5407@METAL2)  ANTENNAMAXCUTCARx1(0.2134@VIA12)  ANTENNAMODELx1(OXIDE1)  ANTENNAPARTIALCUTAREAx1(0.0676@VIA12)  ANTENNAPARTIALMETALSIDEAREAx2(9.5665@METAL1,0.9540@METAL2)
mux2           A0       INOUT   INPUT_by_name           ANTENNAGATEAREAx2(0.1584@METAL2,0.1584@METAL1)  ANTENNAMAXAREACARx1(1.2784@METAL2)  ANTENNAMAXCUTCARx1(0.4268@VIA12)  ANTENNAMODELx1(OXIDE1)  ANTENNAPARTIALCUTAREAx1(0.0676@VIA12)  ANTENNAPARTIALMETALSIDEAREAx2(0.9540@METAL1,0.9540@METAL2)

mux2i          Y        INOUT   OUTPUT_by_name          ANTENNADIFFAREAx2(0.5768@METAL2,0.5768@METAL1)  ANTENNAPARTIALCUTAREAx1(0.1352@VIA12)  ANTENNAPARTIALMETALSIDEAREAx2(5.8565@METAL1,1.4310@METAL2)
mux2i          A0       INOUT   INPUT_by_name           ANTENNAGATEAREAx2(0.1584@METAL2,0.1584@METAL1)  ANTENNAMAXAREACARx1(2.7557@METAL2)  ANTENNAMAXCUTCARx1(0.8535@VIA12)  ANTENNAMODELx1(OXIDE1)  ANTENNAPARTIALCUTAREAx1(0.1352@VIA12)  ANTENNAPARTIALMETALSIDEAREAx2(1.5052@METAL1,1.5052@METAL2)
mux2i          A1       INOUT   INPUT_by_name           ANTENNAGATEAREAx2(0.1584@METAL2,0.1584@METAL1)  ANTENNAMAXAREACARx1(1.2784@METAL2)  ANTENNAMAXCUTCARx1(0.4268@VIA12)  ANTENNAMODELx1(OXIDE1)  ANTENNAPARTIALCUTAREAx1(0.0676@VIA12)  ANTENNAPARTIALMETALSIDEAREAx2(0.9540@METAL1,0.9540@METAL2)
mux2i          S        INOUT   INPUT_by_name           ANTENNAGATEAREAx2(0.3168@METAL2,0.3168@METAL1)  ANTENNAMAXAREACARx1(1.0795@METAL2)  ANTENNAMAXCUTCARx1(0.4268@VIA12)  ANTENNAMODELx1(OXIDE1)  ANTENNAPARTIALCUTAREAx1(0.1352@VIA12)  ANTENNAPARTIALMETALSIDEAREAx2(1.3568@METAL1,1.4310@METAL2)

nand2_1        A        INOUT   INPUT_by_name           ANTENNAGATEAREAx2(0.1980@METAL2,0.1980@METAL1)  ANTENNAMAXAREACARx1(1.8879@METAL2)  ANTENNAMAXCUTCARx1(0.6828@VIA12)  ANTENNAMODELx1(OXIDE1)  ANTENNAPARTIALCUTAREAx1(0.1352@VIA12)  ANTENNAPARTIALMETALSIDEAREAx2(1.3886@METAL1,1.4204@METAL2)
nand2_1        B        INOUT   INPUT_by_name           ANTENNAGATEAREAx2(0.1980@METAL2,0.1980@METAL1)  ANTENNAMAXAREACARx1(1.8879@METAL2)  ANTENNAMAXCUTCARx1(0.6828@VIA12)  ANTENNAMODELx1(OXIDE1)  ANTENNAPARTIALCUTAREAx1(0.1352@VIA12)  ANTENNAPARTIALMETALSIDEAREAx2(1.3886@METAL1,1.4204@METAL2)
nand2_1        Y        INOUT   OUTPUT_by_name          ANTENNADIFFAREAx2(0.5676@METAL2,0.5676@METAL1)  ANTENNAPARTIALCUTAREAx1(0.1352@VIA12)  ANTENNAPARTIALMETALSIDEAREAx2(6.4395@METAL1,1.3886@METAL2)

nand2_2        Y        INOUT   OUTPUT_by_name          ANTENNADIFFAREAx2(1.1352@METAL2,1.1352@METAL1)  ANTENNAPARTIALCUTAREAx1(0.1352@VIA12)  ANTENNAPARTIALMETALSIDEAREAx2(8.5648@METAL1,1.3568@METAL2)
nand2_2        A        INOUT   INPUT_by_name           ANTENNAGATEAREAx2(0.3960@METAL2,0.3960@METAL1)  ANTENNAMAXAREACARx1(0.8636@METAL2)  ANTENNAMAXCUTCARx1(0.3414@VIA12)  ANTENNAMODELx1(OXIDE1)  ANTENNAPARTIALCUTAREAx1(0.1352@VIA12)  ANTENNAPARTIALMETALSIDEAREAx2(1.3568@METAL1,1.3568@METAL2)
nand2_2        B        INOUT   INPUT_by_name           ANTENNAGATEAREAx2(0.3960@METAL2,0.3960@METAL1)  ANTENNAMAXAREACARx1(0.8636@METAL2)  ANTENNAMAXCUTCARx1(0.3414@VIA12)  ANTENNAMODELx1(OXIDE1)  ANTENNAPARTIALCUTAREAx1(0.1352@VIA12)  ANTENNAPARTIALMETALSIDEAREAx2(1.3568@METAL1,1.3568@METAL2)

nand2_4        B        INOUT   INPUT_by_name           ANTENNAGATEAREAx2(0.7920@METAL2,0.7920@METAL1)  ANTENNAMAXAREACARx1(1.6932@METAL2)  ANTENNAMAXCUTCARx1(0.1707@VIA12)  ANTENNAMODELx1(OXIDE1)  ANTENNAPARTIALCUTAREAx1(0.1352@VIA12)  ANTENNAPARTIALMETALAREAx1(0.2025@METAL2)  ANTENNAPARTIALMETALSIDEAREAx2(3.1588@METAL1,1.9080@METAL2)
nand2_4        Y        INOUT   OUTPUT_by_name          ANTENNADIFFAREAx2(2.2064@METAL2,2.2064@METAL1)  ANTENNAPARTIALCUTAREAx1(0.2028@VIA12)  ANTENNAPARTIALMETALSIDEAREAx2(17.2780@METAL1,1.9822@METAL2)
nand2_4        A        INOUT   INPUT_by_name           ANTENNAGATEAREAx2(0.7920@METAL2,0.7920@METAL1)  ANTENNAMAXAREACARx1(1.6932@METAL2)  ANTENNAMAXCUTCARx1(0.1707@VIA12)  ANTENNAMODELx1(OXIDE1)  ANTENNAPARTIALCUTAREAx1(0.1352@VIA12)  ANTENNAPARTIALMETALAREAx1(0.2025@METAL2)  ANTENNAPARTIALMETALSIDEAREAx2(3.1588@METAL1,1.9080@METAL2)

nand2_8        A        INOUT   INPUT_by_name           ANTENNAGATEAREAx2(1.5840@METAL2,1.5840@METAL1)  ANTENNAMAXAREACARx1(1.3602@METAL2)  ANTENNAMAXCUTCARx1(0.0854@VIA12)  ANTENNAMODELx1(OXIDE1)  ANTENNAPARTIALCUTAREAx1(0.1352@VIA12)  ANTENNAPARTIALMETALAREAx1(0.2025@METAL2)  ANTENNAPARTIALMETALSIDEAREAx2(8.0454@METAL1,1.9080@METAL2)
nand2_8        Y        INOUT   OUTPUT_by_name          ANTENNADIFFAREAx2(4.4128@METAL2,4.4128@METAL1)  ANTENNAPARTIALCUTAREAx1(0.2028@VIA12)  ANTENNAPARTIALMETALSIDEAREAx2(32.9872@METAL1,1.9822@METAL2)
nand2_8        B        INOUT   INPUT_by_name           ANTENNAGATEAREAx2(1.5840@METAL2,1.5840@METAL1)  ANTENNAMAXAREACARx1(1.3602@METAL2)  ANTENNAMAXCUTCARx1(0.0854@VIA12)  ANTENNAMODELx1(OXIDE1)  ANTENNAPARTIALCUTAREAx1(0.1352@VIA12)  ANTENNAPARTIALMETALAREAx1(0.2025@METAL2)  ANTENNAPARTIALMETALSIDEAREAx2(8.0454@METAL1,1.9080@METAL2)

nand2b_1       B        INOUT   INPUT_by_name           ANTENNAGATEAREAx2(0.1980@METAL2,0.1980@METAL1)  ANTENNAMAXAREACARx1(1.0227@METAL2)  ANTENNAMAXCUTCARx1(0.3414@VIA12)  ANTENNAMODELx1(OXIDE1)  ANTENNAPARTIALCUTAREAx1(0.0676@VIA12)  ANTENNAPARTIALMETALSIDEAREAx2(0.9540@METAL1,0.9540@METAL2)
nand2b_1       Y        INOUT   OUTPUT_by_name          ANTENNADIFFAREAx2(0.5676@METAL2,0.5676@METAL1)  ANTENNAPARTIALCUTAREAx1(0.1352@VIA12)  ANTENNAPARTIALMETALSIDEAREAx2(8.6443@METAL1,1.9822@METAL2)
nand2b_1       A_N      INOUT   INPUT_by_name           ANTENNAGATEAREAx2(0.1584@METAL2,0.1584@METAL1)  ANTENNAMAXAREACARx1(1.2784@METAL2)  ANTENNAMAXCUTCARx1(0.4268@VIA12)  ANTENNAMODELx1(OXIDE1)  ANTENNAPARTIALCUTAREAx1(0.0676@VIA12)  ANTENNAPARTIALMETALSIDEAREAx2(0.9540@METAL1,0.9540@METAL2)

nand4_1        Y        INOUT   OUTPUT_by_name          ANTENNADIFFAREAx2(1.1352@METAL2,0.3564@METAL1)  ANTENNAPARTIALCUTAREAx1(0.0676@VIA12)  ANTENNAPARTIALMETALSIDEAREAx2(7.0384@METAL1,7.9765@METAL2)
nand4_1        B        INOUT   INPUT_by_name           ANTENNAGATEAREAx2(0.2772@METAL2,0.2772@METAL1)  ANTENNAMAXAREACARx1(1.2581@METAL2)  ANTENNAMAXCUTCARx1(0.2439@VIA12)  ANTENNAMODELx1(OXIDE1)  ANTENNAPARTIALCUTAREAx1(0.0676@VIA12)  ANTENNAPARTIALMETALSIDEAREAx2(1.2879@METAL1,1.2720@METAL2)
nand4_1        C        INOUT   INPUT_by_name           ANTENNAGATEAREAx2(0.2772@METAL2,0.2772@METAL1)  ANTENNAMAXAREACARx1(1.2581@METAL2)  ANTENNAMAXCUTCARx1(0.2439@VIA12)  ANTENNAMODELx1(OXIDE1)  ANTENNAPARTIALCUTAREAx1(0.0676@VIA12)  ANTENNAPARTIALMETALSIDEAREAx2(1.2879@METAL1,1.2720@METAL2)
nand4_1        D        INOUT   INPUT_by_name           ANTENNAGATEAREAx2(0.2772@METAL2,0.2772@METAL1)  ANTENNAMAXAREACARx1(1.2175@METAL2)  ANTENNAMAXCUTCARx1(0.2439@VIA12)  ANTENNAMODELx1(OXIDE1)  ANTENNAPARTIALCUTAREAx1(0.0676@VIA12)  ANTENNAPARTIALMETALSIDEAREAx2(1.2720@METAL1,1.2720@METAL2)
nand4_1        A        INOUT   INPUT_by_name           ANTENNAGATEAREAx2(0.2772@METAL2,0.2772@METAL1)  ANTENNAMAXAREACARx1(1.1364@METAL2)  ANTENNAMAXCUTCARx1(0.2439@VIA12)  ANTENNAMODELx1(OXIDE1)  ANTENNAPARTIALCUTAREAx1(0.0676@VIA12)  ANTENNAPARTIALMETALSIDEAREAx2(1.2190@METAL1,1.2190@METAL2)

nor2_1         Y        INOUT   OUTPUT_by_name          ANTENNADIFFAREAx2(0.5768@METAL2,0.5768@METAL1)  ANTENNAPARTIALCUTAREAx1(0.2028@VIA12)  ANTENNAPARTIALMETALSIDEAREAx2(8.0984@METAL1,1.9822@METAL2)
nor2_1         A        INOUT   INPUT_by_name           ANTENNAGATEAREAx2(0.2772@METAL2,0.2772@METAL1)  ANTENNAMAXAREACARx2(2.1916@METAL2,0.7305@METAL1)  ANTENNAMAXCUTCARx1(0.4877@VIA12)  ANTENNAMODELx1(OXIDE1)  ANTENNAPARTIALCUTAREAx1(0.1352@VIA12)  ANTENNAPARTIALMETALAREAx2(0.2025@METAL2,0.2025@METAL1)  ANTENNAPARTIALMETALSIDEAREAx2(1.9080@METAL1,1.9080@METAL2)
nor2_1         B        INOUT   INPUT_by_name           ANTENNAGATEAREAx2(0.2772@METAL2,0.2772@METAL1)  ANTENNAMAXAREACARx2(2.1916@METAL2,0.7305@METAL1)  ANTENNAMAXCUTCARx1(0.4877@VIA12)  ANTENNAMODELx1(OXIDE1)  ANTENNAPARTIALCUTAREAx1(0.1352@VIA12)  ANTENNAPARTIALMETALAREAx2(0.2025@METAL2,0.2025@METAL1)  ANTENNAPARTIALMETALSIDEAREAx2(1.9080@METAL1,1.9080@METAL2)

nor2_4         Y        INOUT   OUTPUT_by_name          ANTENNADIFFAREAx2(2.3072@METAL2,2.3072@METAL1)  ANTENNAPARTIALCUTAREAx1(0.2028@VIA12)  ANTENNAPARTIALMETALSIDEAREAx2(25.6414@METAL1,1.9822@METAL2)
nor2_4         A        INOUT   INPUT_by_name           ANTENNAGATEAREAx2(1.1088@METAL2,1.1088@METAL1)  ANTENNAMAXAREACARx1(2.3255@METAL2)  ANTENNAMAXCUTCARx1(0.1829@VIA12)  ANTENNAMODELx1(OXIDE1)  ANTENNAPARTIALCUTAREAx1(0.2028@VIA12)  ANTENNAPARTIALMETALAREAx1(0.4050@METAL2)  ANTENNAPARTIALMETALSIDEAREAx2(5.5968@METAL1,2.8620@METAL2)
nor2_4         B        INOUT   INPUT_by_name           ANTENNAGATEAREAx2(1.1088@METAL2,1.1088@METAL1)  ANTENNAMAXAREACARx1(2.3255@METAL2)  ANTENNAMAXCUTCARx1(0.1829@VIA12)  ANTENNAMODELx1(OXIDE1)  ANTENNAPARTIALCUTAREAx1(0.2028@VIA12)  ANTENNAPARTIALMETALAREAx1(0.4050@METAL2)  ANTENNAPARTIALMETALSIDEAREAx2(5.5968@METAL1,2.8620@METAL2)

nor2_8         Y        INOUT   OUTPUT_by_name          ANTENNADIFFAREAx2(4.6144@METAL2,4.6144@METAL1)  ANTENNAPARTIALCUTAREAx1(0.2028@VIA12)  ANTENNAPARTIALMETALSIDEAREAx2(48.8713@METAL1,2.0034@METAL2)
nor2_8         A        INOUT   INPUT_by_name           ANTENNAGATEAREAx2(2.2176@METAL2,2.2176@METAL1)  ANTENNAMAXAREACARx1(2.2534@METAL2)  ANTENNAMAXCUTCARx1(0.0610@VIA12)  ANTENNAMODELx1(OXIDE1)  ANTENNAPARTIALCUTAREAx1(0.1352@VIA12)  ANTENNAPARTIALMETALAREAx1(0.2025@METAL2)  ANTENNAPARTIALMETALSIDEAREAx2(11.7713@METAL1,1.9080@METAL2)
nor2_8         B        INOUT   INPUT_by_name           ANTENNAGATEAREAx2(2.2176@METAL2,2.2176@METAL1)  ANTENNAMAXAREACARx1(2.2534@METAL2)  ANTENNAMAXCUTCARx1(0.0610@VIA12)  ANTENNAMODELx1(OXIDE1)  ANTENNAPARTIALCUTAREAx1(0.1352@VIA12)  ANTENNAPARTIALMETALAREAx1(0.2025@METAL2)  ANTENNAPARTIALMETALSIDEAREAx2(11.7713@METAL1,1.9080@METAL2)

o21ai_1        A2       INOUT   INPUT_by_name           ANTENNAGATEAREAx2(0.3168@METAL2,0.3168@METAL1)  ANTENNAMAXAREACARx1(1.4062@METAL2)  ANTENNAMAXCUTCARx1(0.2134@VIA12)  ANTENNAMODELx1(OXIDE1)  ANTENNAPARTIALCUTAREAx1(0.0676@VIA12)  ANTENNAPARTIALMETALSIDEAREAx2(2.5281@METAL1,0.9540@METAL2)
o21ai_1        Y        INOUT   OUTPUT_by_name          ANTENNADIFFAREAx2(0.8844@METAL2,0.8844@METAL1)  ANTENNAPARTIALCUTAREAx1(0.0676@VIA12)  ANTENNAPARTIALMETALSIDEAREAx2(10.4887@METAL1,0.9540@METAL2)
o21ai_1        B1       INOUT   INPUT_by_name           ANTENNAGATEAREAx2(0.1980@METAL2,0.1980@METAL1)  ANTENNAMAXAREACARx1(1.0227@METAL2)  ANTENNAMAXCUTCARx1(0.3414@VIA12)  ANTENNAMODELx1(OXIDE1)  ANTENNAPARTIALCUTAREAx1(0.0676@VIA12)  ANTENNAPARTIALMETALSIDEAREAx2(0.9540@METAL1,0.9540@METAL2)
o21ai_1        A1       INOUT   INPUT_by_name           ANTENNAGATEAREAx2(0.3168@METAL2,0.3168@METAL1)  ANTENNAMAXAREACARx1(1.4062@METAL2)  ANTENNAMAXCUTCARx1(0.2134@VIA12)  ANTENNAMODELx1(OXIDE1)  ANTENNAPARTIALCUTAREAx1(0.0676@VIA12)  ANTENNAPARTIALMETALSIDEAREAx2(2.5281@METAL1,0.9540@METAL2)

o21ai_2        A2       INOUT   INPUT_by_name           ANTENNAGATEAREAx2(0.6336@METAL2,0.6336@METAL1)  ANTENNAMAXAREACARx1(1.0735@METAL2)  ANTENNAMAXCUTCARx1(0.1067@VIA12)  ANTENNAMODELx1(OXIDE1)  ANTENNAPARTIALCUTAREAx1(0.0676@VIA12)  ANTENNAPARTIALMETALSIDEAREAx2(3.2807@METAL1,0.9540@METAL2)
o21ai_2        Y        INOUT   OUTPUT_by_name          ANTENNADIFFAREAx2(1.5100@METAL2,0.2204@METAL1)  ANTENNAPARTIALCUTAREAx1(0.0676@VIA12)  ANTENNAPARTIALMETALSIDEAREAx2(13.0221@METAL1,5.2205@METAL2)
o21ai_2        B1       INOUT   INPUT_by_name           ANTENNAGATEAREAx2(0.3960@METAL2,0.3960@METAL1)  ANTENNAMAXAREACARx1(1.7177@METAL2)  ANTENNAMAXCUTCARx1(0.1707@VIA12)  ANTENNAMODELx1(OXIDE1)  ANTENNAPARTIALCUTAREAx1(0.0676@VIA12)  ANTENNAPARTIALMETALSIDEAREAx2(3.2807@METAL1,0.9540@METAL2)
o21ai_2        A1       INOUT   INPUT_by_name           ANTENNAGATEAREAx2(0.6336@METAL2,0.6336@METAL1)  ANTENNAMAXAREACARx1(1.4653@METAL2)  ANTENNAMAXCUTCARx1(0.1067@VIA12)  ANTENNAMODELx1(OXIDE1)  ANTENNAPARTIALCUTAREAx1(0.0676@VIA12)  ANTENNAPARTIALMETALSIDEAREAx2(4.0545@METAL1,0.9540@METAL2)

o21ai_4        B1       INOUT   INPUT_by_name           ANTENNAGATEAREAx2(0.7920@METAL2,0.7920@METAL1)  ANTENNAMAXAREACARx1(2.6062@METAL2)  ANTENNAMAXCUTCARx1(0.1707@VIA12)  ANTENNAMODELx1(OXIDE1)  ANTENNAPARTIALCUTAREAx1(0.1352@VIA12)  ANTENNAPARTIALMETALSIDEAREAx2(8.0401@METAL1,1.3568@METAL2)
o21ai_4        A2       INOUT   INPUT_by_name           ANTENNAGATEAREAx2(1.2672@METAL2,1.2672@METAL1)  ANTENNAMAXAREACARx1(1.4343@METAL2)  ANTENNAMAXCUTCARx1(0.1067@VIA12)  ANTENNAMODELx1(OXIDE1)  ANTENNAPARTIALCUTAREAx1(0.1352@VIA12)  ANTENNAPARTIALMETALSIDEAREAx2(7.2716@METAL1,1.3568@METAL2)
o21ai_4        A1       INOUT   INPUT_by_name           ANTENNAGATEAREAx2(1.2672@METAL2,1.2672@METAL1)  ANTENNAMAXAREACARx1(1.4330@METAL2)  ANTENNAMAXCUTCARx1(0.1067@VIA12)  ANTENNAMODELx1(OXIDE1)  ANTENNAPARTIALCUTAREAx1(0.1352@VIA12)  ANTENNAPARTIALMETALSIDEAREAx2(7.2663@METAL1,1.3568@METAL2)
o21ai_4        Y        INOUT   OUTPUT_by_name          ANTENNADIFFAREAx2(3.0200@METAL2,0.2204@METAL1)  ANTENNAPARTIALCUTAREAx1(0.1352@VIA12)  ANTENNAPARTIALMETALSIDEAREAx2(24.7669@METAL1,9.1849@METAL2)

o21ai_8        B1       INOUT   INPUT_by_name           ANTENNAGATEAREAx2(1.5840@METAL2,1.5840@METAL1)  ANTENNAMAXAREACARx1(3.0001@METAL2)  ANTENNAMAXCUTCARx1(0.1280@VIA12)  ANTENNAMODELx1(OXIDE1)  ANTENNAPARTIALCUTAREAx1(0.2028@VIA12)  ANTENNAPARTIALMETALSIDEAREAx2(15.8046@METAL1,1.9080@METAL2)
o21ai_8        Y        INOUT   OUTPUT_by_name          ANTENNADIFFAREAx2(6.0400@METAL2,0.2204@METAL1)  ANTENNAPARTIALCUTAREAx1(0.1352@VIA12)  ANTENNAPARTIALMETALSIDEAREAx2(40.3224@METAL1,16.9759@METAL2)
o21ai_8        A1       INOUT   INPUT_by_name           ANTENNAGATEAREAx2(2.5344@METAL2,2.5344@METAL1)  ANTENNAMAXAREACARx1(1.6546@METAL2)  ANTENNAMAXCUTCARx1(0.0533@VIA12)  ANTENNAMODELx1(OXIDE1)  ANTENNAPARTIALCUTAREAx1(0.1352@VIA12)  ANTENNAPARTIALMETALSIDEAREAx2(14.6068@METAL1,1.3568@METAL2)
o21ai_8        A2       INOUT   INPUT_by_name           ANTENNAGATEAREAx2(2.5344@METAL2,2.5344@METAL1)  ANTENNAMAXAREACARx1(1.6278@METAL2)  ANTENNAMAXCUTCARx1(0.0533@VIA12)  ANTENNAMODELx1(OXIDE1)  ANTENNAPARTIALCUTAREAx1(0.1352@VIA12)  ANTENNAPARTIALMETALSIDEAREAx2(14.3948@METAL1,1.3568@METAL2)

xnor2_1        A        INOUT   INPUT_by_name           ANTENNAGATEAREAx2(0.5148@METAL2,0.5148@METAL1)  ANTENNAMAXAREACARx1(0.9274@METAL2)  ANTENNAMAXCUTCARx1(0.1313@VIA12)  ANTENNAMODELx1(OXIDE1)  ANTENNAPARTIALCUTAREAx1(0.0676@VIA12)  ANTENNAPARTIALMETALSIDEAREAx2(2.5387@METAL1,0.9540@METAL2)
xnor2_1        Y        INOUT   OUTPUT_by_name          ANTENNADIFFAREAx2(0.8844@METAL2,0.8844@METAL1)  ANTENNAPARTIALCUTAREAx1(0.2028@VIA12)  ANTENNAPARTIALMETALSIDEAREAx2(10.6636@METAL1,1.9080@METAL2)
xnor2_1        B        INOUT   INPUT_by_name           ANTENNAGATEAREAx2(0.5148@METAL2,0.1980@METAL1)  ANTENNAMAXAREACARx1(5.7311@METAL2)  ANTENNAMAXCUTCARx1(0.6828@VIA12)  ANTENNAMODELx1(OXIDE1)  ANTENNAPARTIALCUTAREAx1(0.1352@VIA12)  ANTENNAPARTIALMETALAREAx1(0.6491@METAL2)  ANTENNAPARTIALMETALSIDEAREAx2(6.8052@METAL1,4.9502@METAL2)

xor2_1         X        INOUT   OUTPUT_by_name          ANTENNADIFFAREAx2(0.7660@METAL2,0.7660@METAL1)  ANTENNAPARTIALCUTAREAx1(0.1352@VIA12)  ANTENNAPARTIALMETALSIDEAREAx2(8.2256@METAL1,1.4310@METAL2)
xor2_1         B        INOUT   INPUT_by_name           ANTENNAGATEAREAx2(0.5940@METAL2,0.5940@METAL1)  ANTENNAMAXAREACARx1(3.9665@METAL2)  ANTENNAMAXCUTCARx1(0.4552@VIA12)  ANTENNAMODELx1(OXIDE1)  ANTENNAPARTIALCUTAREAx1(0.2704@VIA12)  ANTENNAPARTIALMETALAREAx1(0.3710@METAL2)  ANTENNAPARTIALMETALSIDEAREAx2(9.8845@METAL1,3.6305@METAL2)
xor2_1         A        INOUT   INPUT_by_name           ANTENNAGATEAREAx2(0.5940@METAL2,0.5940@METAL1)  ANTENNAMAXAREACARx1(0.3409@METAL2)  ANTENNAMAXCUTCARx1(0.1138@VIA12)  ANTENNAMODELx1(OXIDE1)  ANTENNAPARTIALCUTAREAx1(0.0676@VIA12)  ANTENNAPARTIALMETALSIDEAREAx2(0.9540@METAL1,1.4628@METAL2)

==============================================================================
SUMMARY
==============================================================================
Cells COMPLETE (38):
  a211o_2
  a21oi_1
  a21oi_2
  a21oi_4
  a21oi_8
  a22oi_1
  a22oi_2
  buf_1
  buf_16
  buf_2
  buf_4
  buf_8
  dfrtp_1
  dfsbp_1
  dfxtp_1
  dlxbp_1
  inv_1
  inv_16
  inv_2
  inv_4
  inv_8
  mux2
  mux2i
  nand2_1
  nand2_2
  nand2_4
  nand2_8
  nand2b_1
  nand4_1
  nor2_1
  nor2_4
  nor2_8
  o21ai_1
  o21ai_2
  o21ai_4
  o21ai_8
  xnor2_1
  xor2_1

Cells MISSING data (0):

------------------------------------------------------------------------------
PATTERN HINT: attributes present on COMPLETE cells
------------------------------------------------------------------------------
  On INPUT pins of complete cells:
    ANTENNAPARTIALCUTAREA           on 88 pins
    ANTENNAMAXCUTCAR                on 88 pins
    ANTENNAGATEAREA                 on 88 pins
    ANTENNAMODEL                    on 88 pins
    ANTENNAPARTIALMETALSIDEAREA     on 88 pins
    ANTENNAMAXAREACAR               on 88 pins
    ANTENNAPARTIALMETALAREA         on 18 pins
    ANTENNADIFFAREA                 on 2 pins

  On OUTPUT pins of complete cells:
    ANTENNADIFFAREA                 on 40 pins
    ANTENNAPARTIALCUTAREA           on 40 pins
    ANTENNAPARTIALMETALSIDEAREA     on 40 pins
    ANTENNAPARTIALMETALAREA         on 4 pins
    ANTENNAMAXCUTCAR                on 1 pins
    ANTENNAGATEAREA                 on 1 pins
    ANTENNAMODEL                    on 1 pins
    ANTENNAMAXAREACAR               on 1 pins

------------------------------------------------------------------------------
FAMILY COMPARISON
------------------------------------------------------------------------------

  Family 'a211o': ['a211o_2']
    a211o_2         X[OUT]=['ANTENNADIFFAREA', 'ANTENNAPARTIALCUTAREA', 'ANTENNAPARTIALMETALSIDEAREA']  |  A2[IN]=['ANTENNAGATEAREA', 'ANTENNAMAXAREACAR', 'ANTENNAMAXCUTCAR', 'ANTENNAMODEL', 'ANTENNAPARTIALCUTAREA', 'ANTENNAPARTIALMETALSIDEAREA']  |  C1[IN]=['ANTENNAGATEAREA', 'ANTENNAMAXAREACAR', 'ANTENNAMAXCUTCAR', 'ANTENNAMODEL', 'ANTENNAPARTIALCUTAREA', 'ANTENNAPARTIALMETALSIDEAREA']  |  B1[IN]=['ANTENNAGATEAREA', 'ANTENNAMAXAREACAR', 'ANTENNAMAXCUTCAR', 'ANTENNAMODEL', 'ANTENNAPARTIALCUTAREA', 'ANTENNAPARTIALMETALSIDEAREA']  |  A1[IN]=['ANTENNAGATEAREA', 'ANTENNAMAXAREACAR', 'ANTENNAMAXCUTCAR', 'ANTENNAMODEL', 'ANTENNAPARTIALCUTAREA', 'ANTENNAPARTIALMETALSIDEAREA']

  Family 'a21oi': ['a21oi_1', 'a21oi_2', 'a21oi_4', 'a21oi_8']
    a21oi_1         Y[OUT]=['ANTENNADIFFAREA', 'ANTENNAPARTIALCUTAREA', 'ANTENNAPARTIALMETALSIDEAREA']  |  A1[IN]=['ANTENNAGATEAREA', 'ANTENNAMAXAREACAR', 'ANTENNAMAXCUTCAR', 'ANTENNAMODEL', 'ANTENNAPARTIALCUTAREA', 'ANTENNAPARTIALMETALSIDEAREA']  |  B1[IN]=['ANTENNAGATEAREA', 'ANTENNAMAXAREACAR', 'ANTENNAMAXCUTCAR', 'ANTENNAMODEL', 'ANTENNAPARTIALCUTAREA', 'ANTENNAPARTIALMETALSIDEAREA']  |  A2[IN]=['ANTENNAGATEAREA', 'ANTENNAMAXAREACAR', 'ANTENNAMAXCUTCAR', 'ANTENNAMODEL', 'ANTENNAPARTIALCUTAREA', 'ANTENNAPARTIALMETALSIDEAREA']
    a21oi_2         Y[OUT]=['ANTENNADIFFAREA', 'ANTENNAPARTIALCUTAREA', 'ANTENNAPARTIALMETALSIDEAREA']  |  A1[IN]=['ANTENNAGATEAREA', 'ANTENNAMAXAREACAR', 'ANTENNAMAXCUTCAR', 'ANTENNAMODEL', 'ANTENNAPARTIALCUTAREA', 'ANTENNAPARTIALMETALSIDEAREA']  |  B1[IN]=['ANTENNAGATEAREA', 'ANTENNAMAXAREACAR', 'ANTENNAMAXCUTCAR', 'ANTENNAMODEL', 'ANTENNAPARTIALCUTAREA', 'ANTENNAPARTIALMETALSIDEAREA']  |  A2[IN]=['ANTENNAGATEAREA', 'ANTENNAMAXAREACAR', 'ANTENNAMAXCUTCAR', 'ANTENNAMODEL', 'ANTENNAPARTIALCUTAREA', 'ANTENNAPARTIALMETALSIDEAREA']
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

==============================================================================
END OF REPORT
==============================================================================
