shreyaans27/RISCV-tapeout/(commit log)

2026-04-14 Minimal RV32IM core - all tests passing
    - RV32IM core with 3-stage pipeline (fetch/decode+execute/mem)
    - DotProd4 custom instruction (4x INT8 MAC)
    - Simple bus crossbar (2 masters, 2 slaves)
    - 8KB SRAM controller (behavioral)
    - 16KB ROM controller (deterministic pattern)
    - JTAG bridge stub
    - Test firmware verifies: LUI, ADDI, LW from ROM, DOTPROD4, SB
    - 108 cycles to complete, all tests PASS
2026-04-14 Refactor: separate SRAM/ROM wrappers for macro swapping
    - New sram_8kb.v: behavioral 8KB SRAM with clean macro-like ports
    - New rom_16kb.v: behavioral 16KB ROM with clean macro-like ports
    - sram_ctrl.v: now instantiates sram_8kb (bus logic only)
    - rom_ctrl.v: now instantiates rom_16kb (bus logic only)
    - For tapeout: swap sram_8kb/rom_16kb internals with real macros
    - For synthesis: blackbox sram_8kb and rom_16kb only
    - All 20 regression tests still pass (788 cycles)
    - syn/min_core_v2.v: concatenated, 11 modules, lint-clean
    [rom_ctrl.v, sram_ctrl.v, tb_top.v]
2026-04-14 v2: Clock divider + external SRAM/ROM macro pins
    Architecture changes:
    - Added clk_div: 200MHz pad_clk → 100MHz → 50MHz
    - Core, JTAG, crossbar all run on clk_50
    - SRAM/ROM macros are EXTERNAL (not in RTL)
    - Controllers output raw macro pins to top-level ports
    - sram_ctrl/rom_ctrl use 3-state FSM (IDLE→ACCESS→RESPOND)
    - Debug ports: debug_pc, debug_resp_valid
    - Testbench has behavioral SRAM/ROM models external to DUT
    All 20 regression tests PASS (989 cycles)
    Bug fixed: resp_valid lingering caused core to latch
    stale data as instruction. Added RESPOND state to
    ensure resp_valid deasserts before req_ready reasserts.
    [clk_div.v, core_top.v, rom_ctrl.v, sram_ctrl.v, tb_debug.v, tb_top.v]
2026-04-15 SRAM controller with real macro timing
    - Posedge/negedge clk_50 timing for SRAM access
    - 10ns precharge (posedge→negedge), 10ns sense (negedge→posedge)
    - No clk_100/clk_200 needed, just both edges of clk_50
    - Real SRAM macro pins: DEN, PRECHG, REN, WEN, EN, A<7:0>, C<2:0>, DIN, DOUT
    - Only supports SW (full word writes), no SB/SH
    - Updated firmware: pass/fail use SW instead of SB
    - Updated testbench: behavioral SRAM model matches macro interface
    - All 20 regression tests PASS (966 cycles)
    [core_top.v, sram_ctrl.v, tb_debug.v, tb_top.v]
2026-04-15 Concatenated RTL for synthesis: min_core_v2.v
    10 modules, 1447 lines, lint-clean
    - Core + ALU + regfile + dotprod4
    - Bus crossbar (2 master, 2 slave)
    - SRAM controller with real macro timing (posedge/negedge)
    - ROM controller with real macro timing (posedge/negedge/clk_200)
    - Clock divider (200→100→50)
    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
2026-04-15 Add comprehensive synthesis and P&R guide
    docs/synthesis_and_pnr_guide.md covers:
    - Synthesis with Genus (SDC, script, post-checks)
    - P&R with Innovus (step-by-step commands)
    - Virtuoso integration (manual routing to macros)
    - Pin mapping tables for SRAM and ROM
    - Clock domain summary
2026-04-16 Added directory for liberate flow
2026-04-16 min_core_v3: split ALU - isolated multiplier from fast path
    - ALU now has result_fast (no multiplier in cone) and separate mul_result outputs
    - MUL pipeline: mul_raw_selected → mul_result_reg → rf_wr_data (2 cycles)
    - Non-MUL ALU: alu_result_fast → rf_wr_data (1 cycle)
    - Verified: mul_result_reg = 0x2a (42 = 7x6), alu_result_fast = 0 during MUL
    - Critical path drops from ~19ns (with multiplier) to ~10ns (add/shift only)
    - All 20 regression tests PASS (968 cycles)
    - Ready for multicycle_path SDC on mul_result_reg
2026-04-18 min_core_v4: FINAL RTL — 28 tests, lint-clean
    10 modules, 1800 lines, Verilator lint-clean
    28 tests verified:
    - 20 instruction regression tests (PASS, 968 cycles)
    - 8 JTAG tests (ALL PASS):
    1. IDCODE 2. BYPASS 3. SRAM W/R 4. Core run
    5. Single-step 6. Halt/Resume 7. ROM read 8. TAP reset
    Architecture:
    - RV32IM core @ clk_25 (25MHz from 100MHz pad_clk)
    - Pipelined MUL (split ALU, 2-cycle)
    - DotProd4 INT8 MAC
    - SRAM ctrl: posedge/negedge clk_25 + negedge pad_clk (REN 2.5ns delay)
    - ROM ctrl: posedge/negedge clk_25 + posedge pad_clk (SAEN 5ns delay)
    - JTAG: IEEE 1149.1 TAP on TCK, toggle CDC to clk_25
    - Clock gating for core single-step
    [clk_div.v, core_top.v, jtag_bridge.v, min_core_v4.v, tb_jtag.v, tb_jtag_debug.v, tb_jtag_minimal.v, tb_jtag_rom.v]
2026-04-22 Added flow tcl scripts and lef patchers (didn't end up using)
2026-09-04 final tcl script for the whole flow - V17
